jordane-quincy/ProjetM1AndroidArduino/(list of files, drawings)

Other design files:
Arduino/Fritzing/Montage.fzz
