jordane-quincy/ProjetM1AndroidArduino/(commit log)

2016-04-29 cleanup code de base
2016-04-30 communication d'un float de l'arduino vers android : ok
2016-05-02 communication d'un msg de android vers l'arduino : ok
2016-05-02 communication du nombre de clignotement de android vers l'arduino : ok
2016-05-03 tempo d'une seconde coté android pour la valeur max de l'IR
2016-05-28 ajout debut de montage fritzing
    [Montage.fzz]
2016-05-28 maj montage
    [Montage.fzz]
2016-05-28 maj montage avec IR
    [Montage.fzz]
2016-05-28 oubli fil donnees IR en A9
    [Montage.fzz]
2016-05-28 fix pb routage ir data
    [Montage.fzz]
2016-05-30 gestion arduino deconnecte
2016-05-31 maj comment + clean code arduino
2016-05-31 fix trad arduino deco
2016-06-01 fix length msg to send
    [CodeAvecCommentaire.ino]
2016-06-01 fait varier la vitesse de la voiture branchee directement dessus
2016-06-01 tourne sur le circuit (apres lancement manuel)
2016-06-01 debut ajout du buz11
    [Montage.fzz]
2016-06-01 maj buz11
    [Montage.fzz]
2016-06-01 remove vibrate
    [Montage.fzz]
2016-06-01 montage ok sur alim arduino
    [Montage.fzz]
2016-06-02 fix typo / comment
    [MCP41100.ino]
2016-06-02 montage ajout alim externe
    [Montage.fzz]
